InduwaraGayashan001/Misprinted-Label-Detection/README.md

# Misprinted Label Detection

This project aims to develop an automated system for detecting misprints on product packaging. By utilizing YOLOv8 for object detection and integrating with a PCB for automated responses, the system identifies and handles packaging errors efficiently.

## Features

- **Object Detection**: Leveraging YOLOv8 for accurate detection of misprints.
- **Automated Response**: Integration with a PCB to manage errors in real-time.
- **Efficiency**: Swift identification and correction of packaging issues.

## System Overview

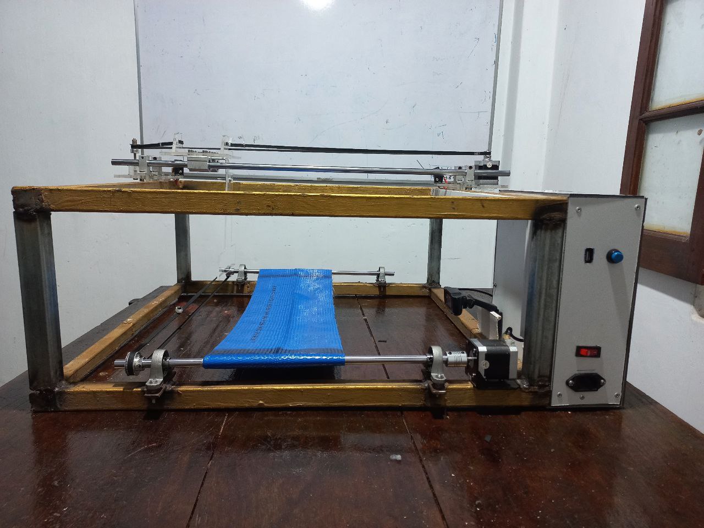
[picture p1: Detection_Results/system.jpg]
System Overview

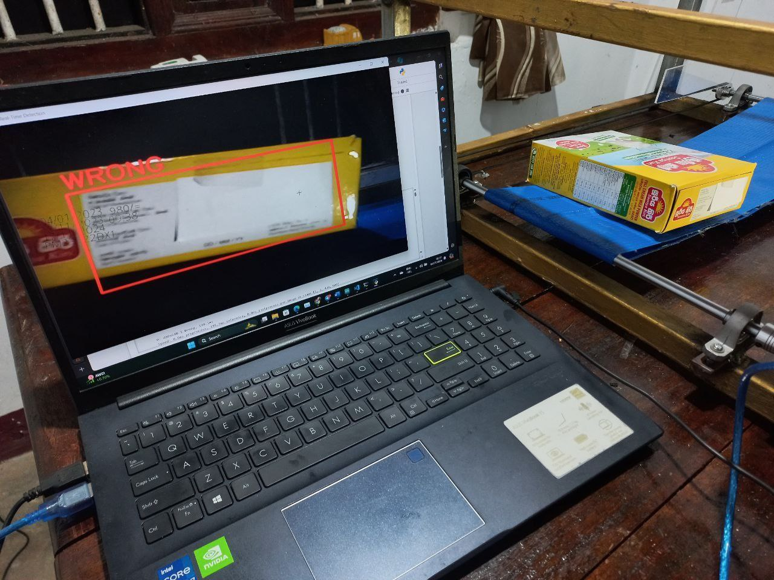
[picture p2: Detection_Results/detection.png]
