InduwaraGayashan001/Misprinted-Label-Detection/Codes/Data Augmentation/Initial data/IMG-20240511-WA0030.jpg

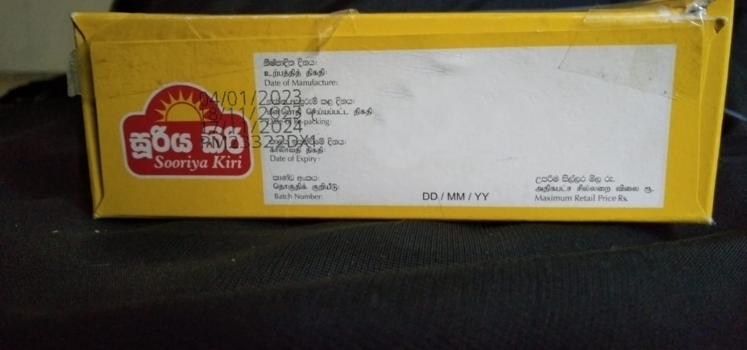
Codes/Data Augmentation/Initial data/IMG-20240511-WA0030.jpg
