InduwaraGayashan001/Misprinted-Label-Detection/Codes/Data Augmentation/Initial data/photo_2_2024-06-20_10-48-59.jpg

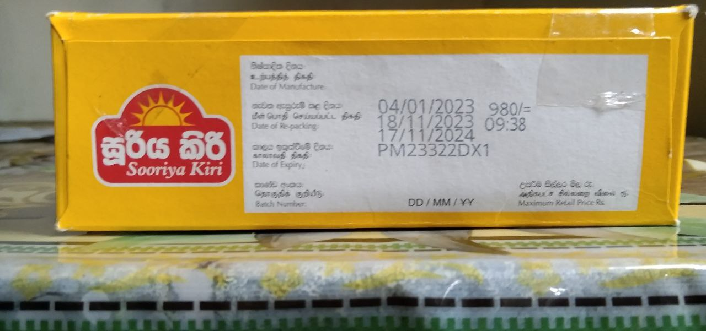
Codes/Data Augmentation/Initial data/photo_2_2024-06-20_10-48-59.jpg
