InduwaraGayashan001/Misprinted-Label-Detection/Solidworks/Mechanical design/Assembly.SLDASM

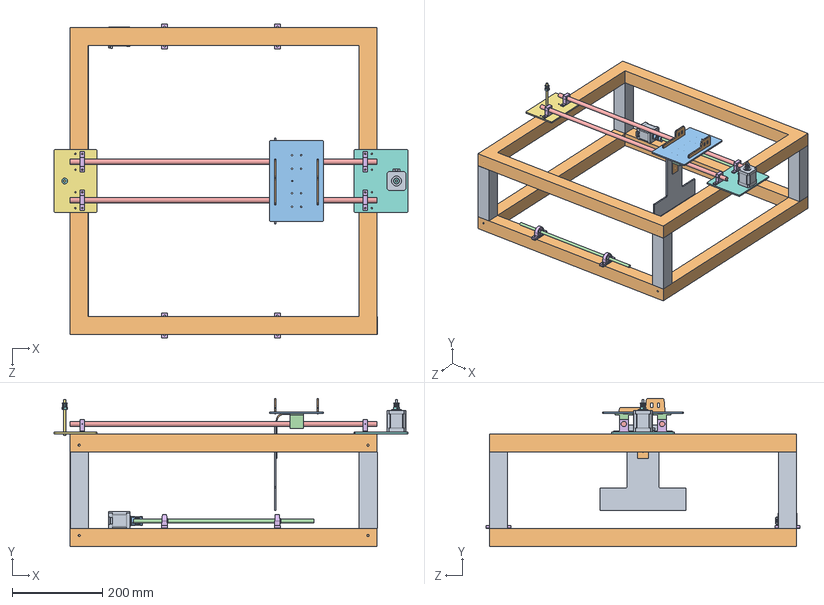
[picture p45: CAD file, 2024-07-12]
Solidworks/Mechanical design/Assembly.SLDASM
784.5 x 329.0 x 695.0 mm
base_frame x 2
vertical_bar x 4
fixed_plate_1
fixed_plate_2
horizontal_bar_holder(fixed) x 4
horizontal bar x 2
horizontal_bar_holder(moving) x 2
moving_plate
supporting_plate x 2
NEMA17 17HS8401 x 2
GT2_Pully_16T_6mm x 2
pulley_holder
pillow_bearing x 4
pillow_bearing_support x 4
conveyor_belt_bar x 2
flexible coupling v1
pushing_plate_holder
pshing_plate_1
