InduwaraGayashan001/Misprinted-Label-Detection/Solidworks/Enclosure design/S-120-12 PSU.SLDPRT

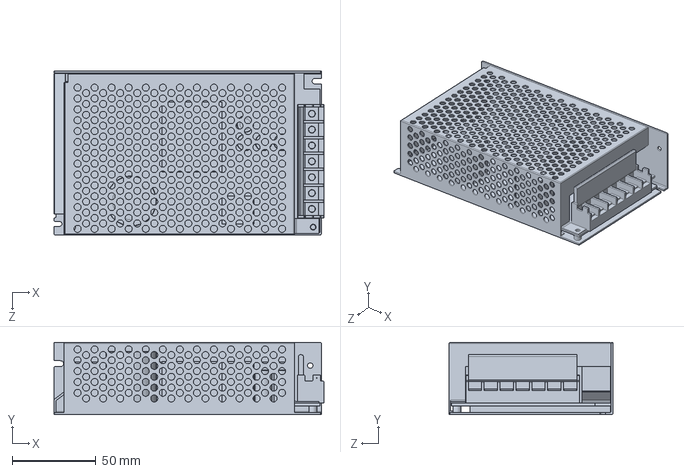
[picture p46: CAD file, 2024-07-12]
Solidworks/Enclosure design/S-120-12 PSU.SLDPRT
161.6 x 43.2 x 98.0 mm
