InduwaraGayashan001/Misprinted-Label-Detection/Solidworks/Mechanical design/NEMA17 17HS8401.SLDPRT

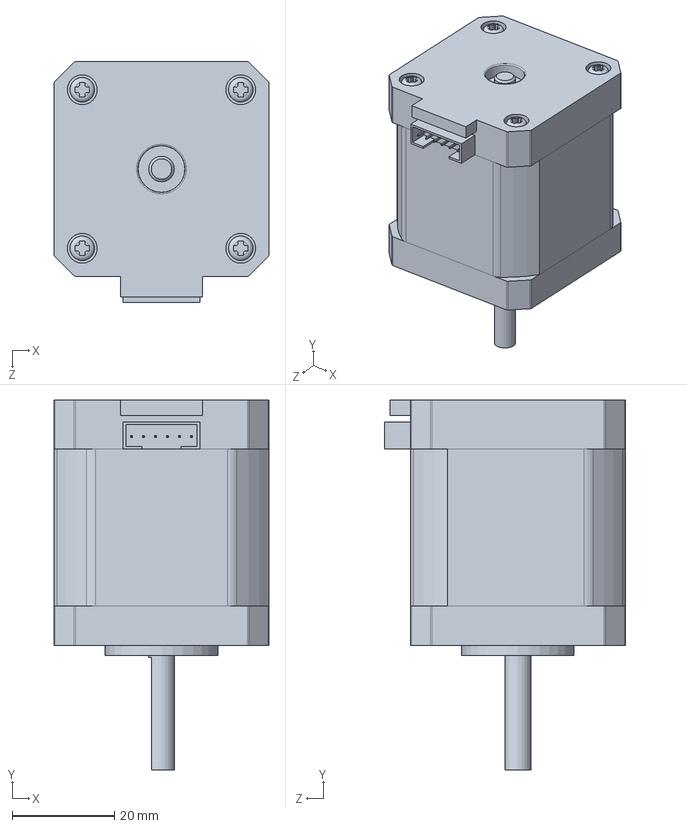
[picture p47: CAD file, 2024-07-12]
Solidworks/Mechanical design/NEMA17 17HS8401.SLDPRT
42.0 x 72.4 x 47.1 mm
