InduwaraGayashan001/Misprinted-Label-Detection/Solidworks/Enclosure design/SMAKN TB6600 Stepper Motor Driver.SLDPRT

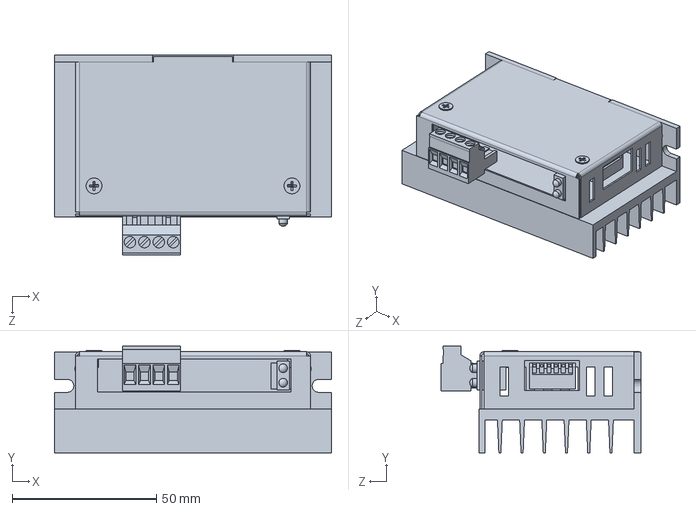
[picture p48: CAD file, 2024-07-12]
Solidworks/Enclosure design/SMAKN TB6600 Stepper Motor Driver.SLDPRT
96.0 x 37.0 x 69.2 mm
