InduwaraGayashan001/Misprinted-Label-Detection/Solidworks/Mechanical design/fixed_plate_1.SLDPRT

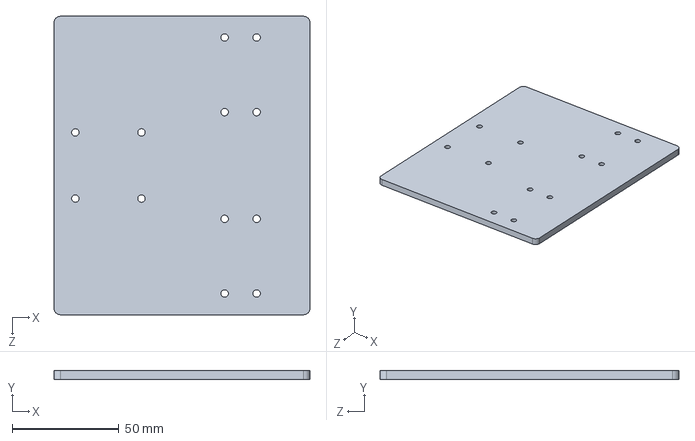
[picture p49: CAD file, 2024-07-12]
Solidworks/Mechanical design/fixed_plate_1.SLDPRT
120.0 x 4.00 x 140.0 mm
