InduwaraGayashan001/Misprinted-Label-Detection/Solidworks/Enclosure design/KCD1-B2-2P-Off.SLDPRT

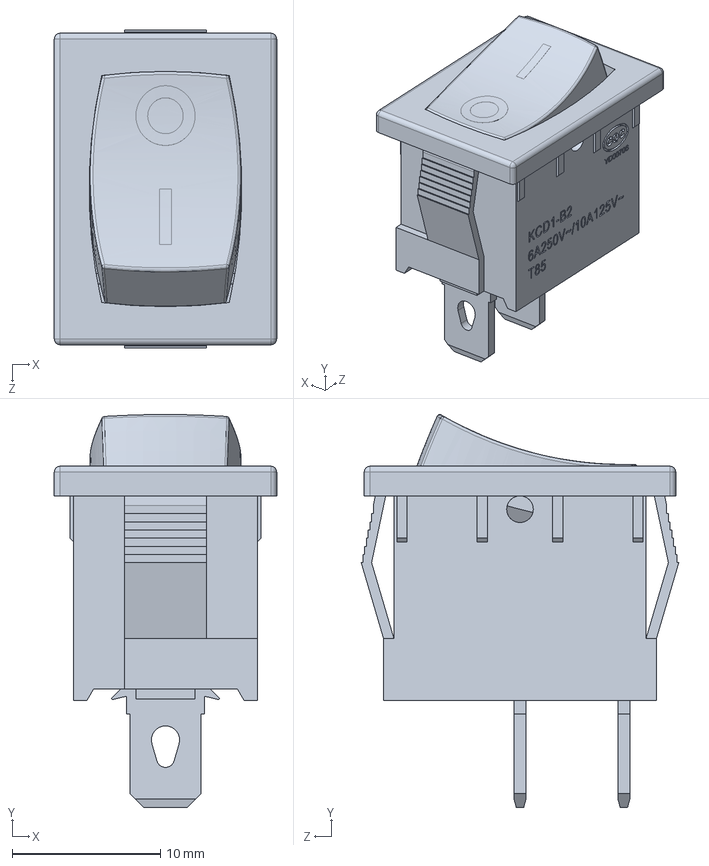
[picture p50: CAD file, 2024-07-12]
Solidworks/Enclosure design/KCD1-B2-2P-Off.SLDPRT
15.0 x 26.5 x 21.4 mm
