InduwaraGayashan001/Misprinted-Label-Detection/Solidworks/Enclosure design/Part2.SLDPRT

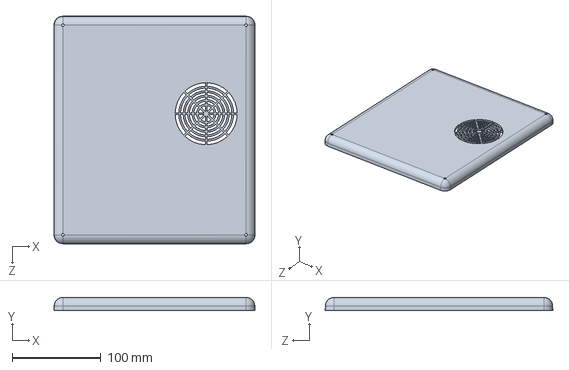
[picture p51: CAD file, 2024-07-12]
Solidworks/Enclosure design/Part2.SLDPRT
226.9 x 15.0 x 256.9 mm
