InduwaraGayashan001/Misprinted-Label-Detection/Solidworks/Mechanical design/pillow_bearing_support.SLDPRT

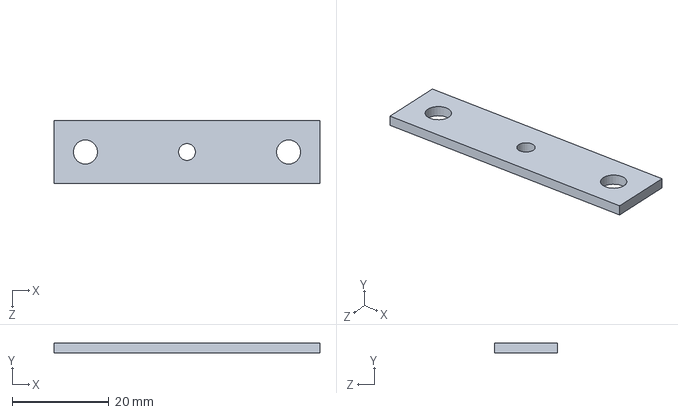
[picture p52: CAD file, 2024-07-12]
Solidworks/Mechanical design/pillow_bearing_support.SLDPRT
55.0 x 2.00 x 13.0 mm
