InduwaraGayashan001/Misprinted-Label-Detection/Solidworks/Enclosure design/Part1.SLDPRT

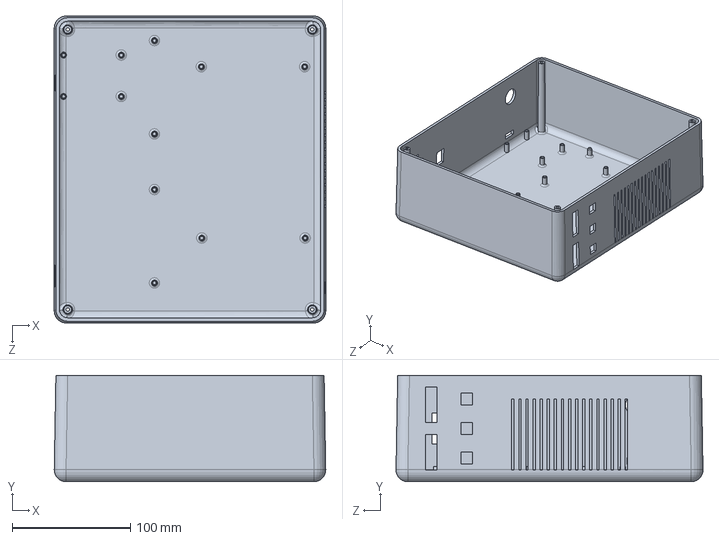
[picture p53: CAD file, 2024-07-12]
Solidworks/Enclosure design/Part1.SLDPRT
229.6 x 90.0 x 259.6 mm
