InduwaraGayashan001/Misprinted-Label-Detection/Solidworks/Mechanical design/horizontal bar.SLDPRT

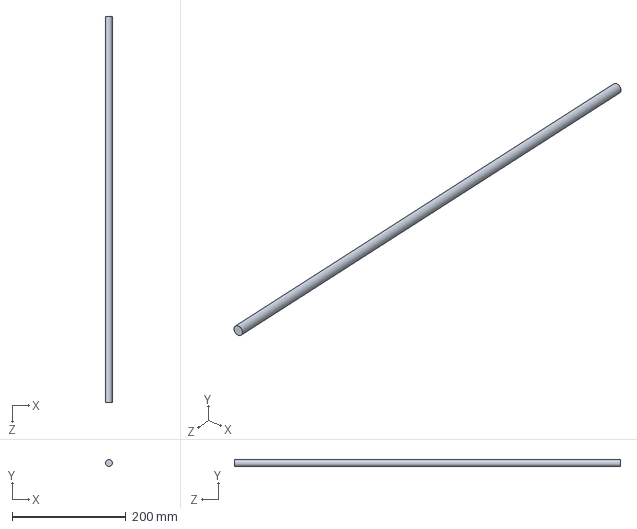
[picture p54: CAD file, 2024-07-12]
Solidworks/Mechanical design/horizontal bar.SLDPRT
12.0 x 12.0 x 680.0 mm
