InduwaraGayashan001/Misprinted-Label-Detection/Solidworks/Enclosure design/16mmPushButton.SLDPRT

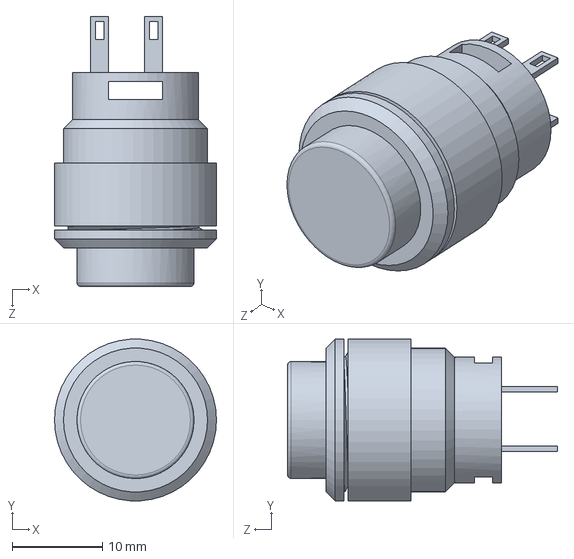
[picture p55: CAD file, 2024-07-12]
Solidworks/Enclosure design/16mmPushButton.SLDPRT
18.0 x 18.0 x 30.0 mm
