InduwaraGayashan001/Misprinted-Label-Detection/Solidworks/Mechanical design/vertical_bar.SLDPRT

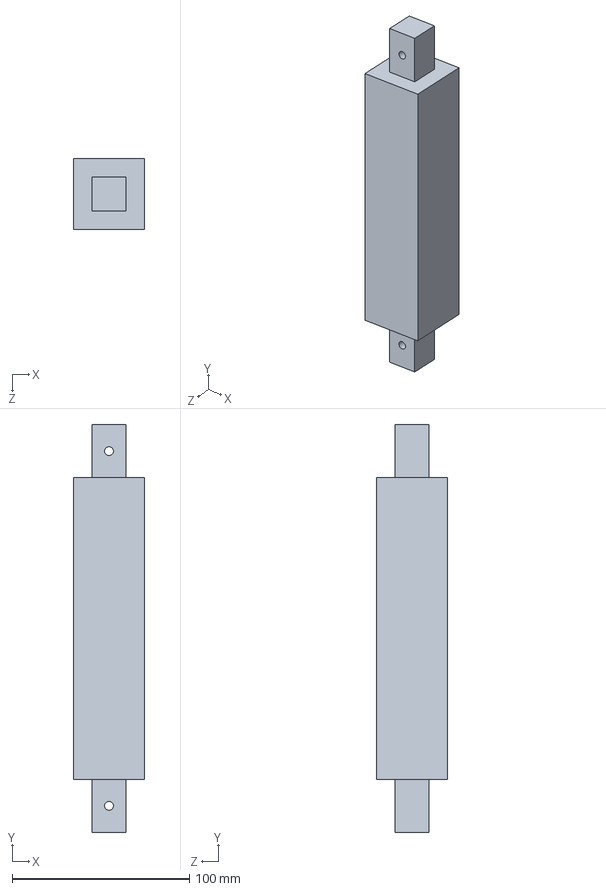
[picture p56: CAD file, 2024-07-12]
Solidworks/Mechanical design/vertical_bar.SLDPRT
40.0 x 230.0 x 40.0 mm
