InduwaraGayashan001/Misprinted-Label-Detection/Solidworks/Enclosure design/HB5_.SLDPRT

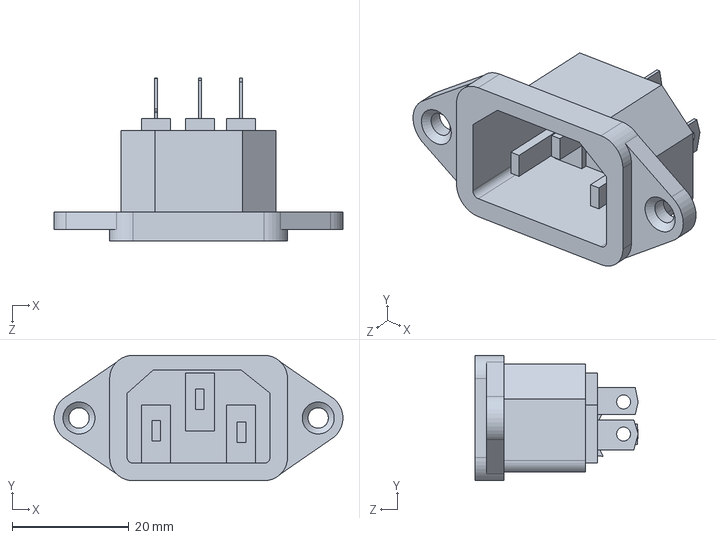
[picture p57: CAD file, 2024-07-12]
Solidworks/Enclosure design/HB5_.SLDPRT
49.5 x 21.5 x 28.0 mm
