InduwaraGayashan001/Misprinted-Label-Detection/Solidworks/Mechanical design/pushing_plate_holder.SLDPRT

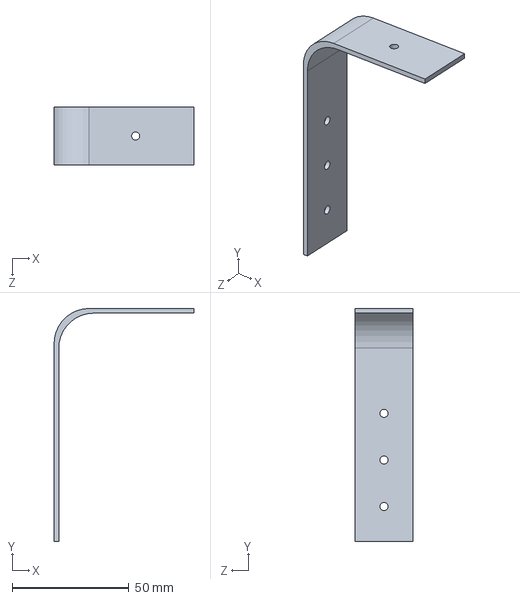
[picture p58: CAD file, 2024-07-12]
Solidworks/Mechanical design/pushing_plate_holder.SLDPRT
60.0 x 100.0 x 25.0 mm
