InduwaraGayashan001/Misprinted-Label-Detection/Solidworks/Mechanical design/horizontal_bar_holder(fixed).SLDPRT

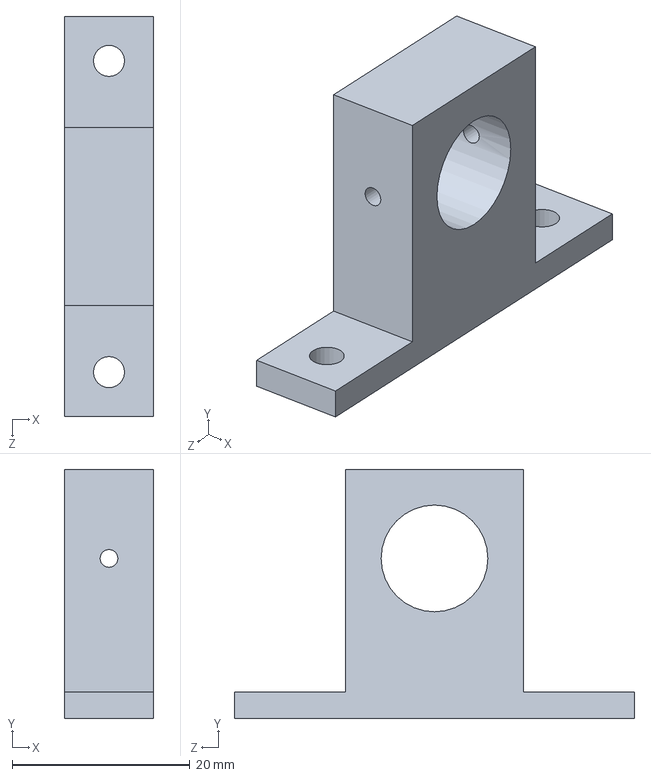
[picture p59: CAD file, 2024-07-12]
Solidworks/Mechanical design/horizontal_bar_holder(fixed).SLDPRT
10.0 x 28.0 x 45.0 mm
