InduwaraGayashan001/Misprinted-Label-Detection/Solidworks/Mechanical design/pulley_holder.SLDPRT

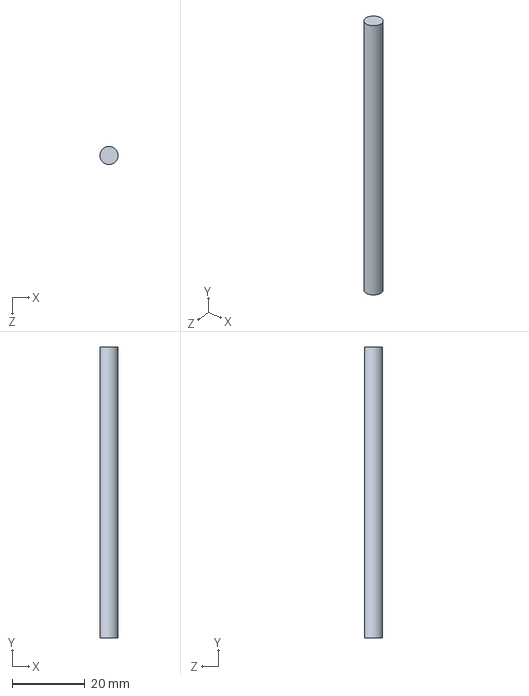
[picture p60: CAD file, 2024-07-12]
Solidworks/Mechanical design/pulley_holder.SLDPRT
4.99 x 80.0 x 5.00 mm
