InduwaraGayashan001/Misprinted-Label-Detection/Solidworks/Mechanical design/base_frame.SLDPRT

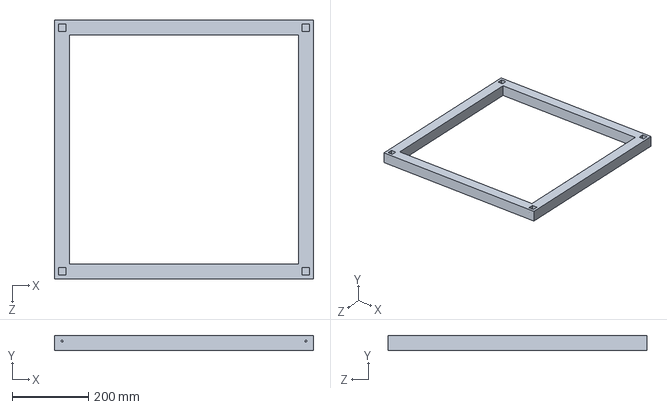
[picture p61: CAD file, 2024-07-12]
Solidworks/Mechanical design/base_frame.SLDPRT
680.0 x 40.0 x 680.0 mm
