InduwaraGayashan001/Misprinted-Label-Detection/Solidworks/Mechanical design/moving_plate.SLDPRT

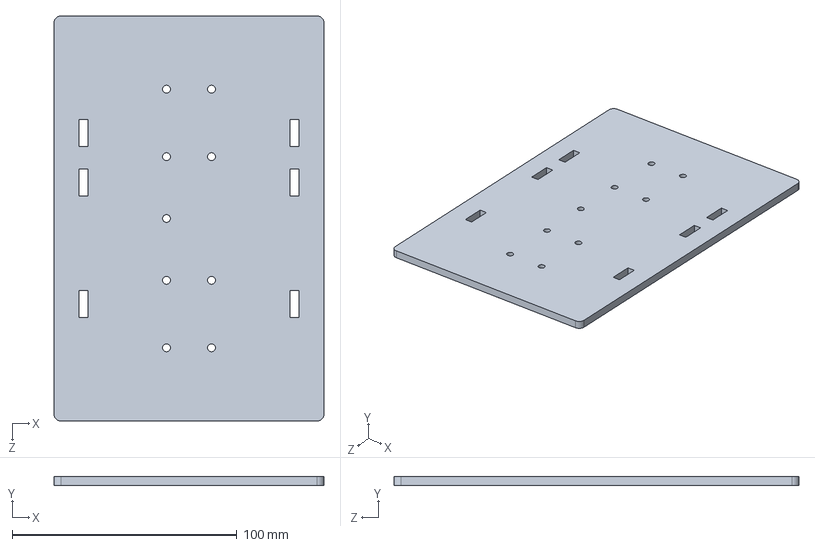
[picture p62: CAD file, 2024-07-12]
Solidworks/Mechanical design/moving_plate.SLDPRT
120.0 x 4.00 x 180.0 mm
