InduwaraGayashan001/Misprinted-Label-Detection/Solidworks/Mechanical design/GT2_Pully_16T_6mm.SLDPRT

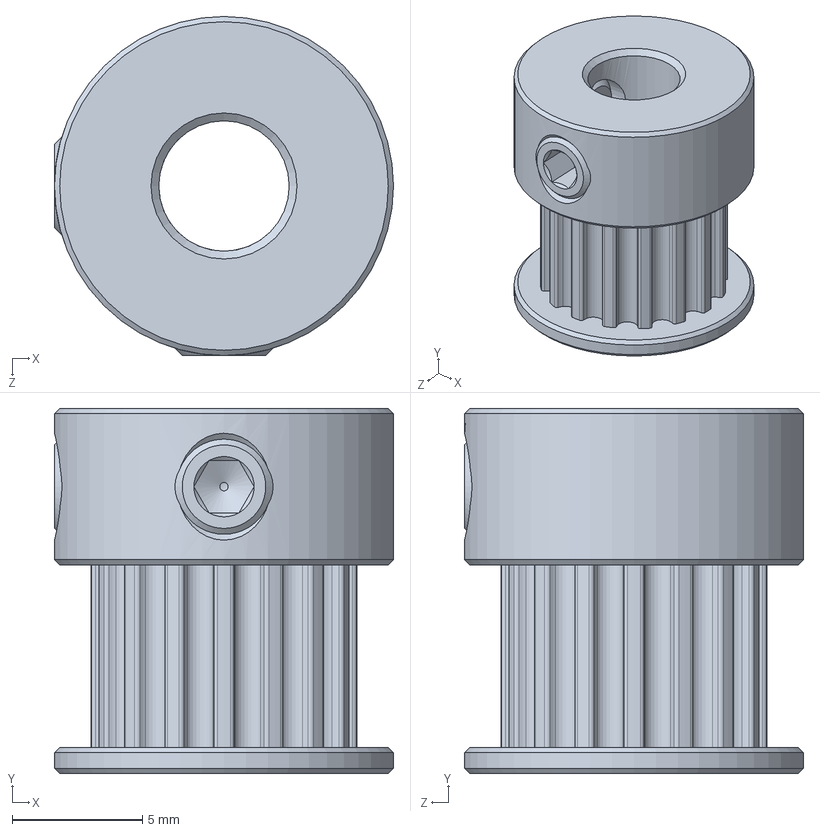
[picture p63: CAD file, 2024-07-12]
Solidworks/Mechanical design/GT2_Pully_16T_6mm.SLDPRT
13.0 x 14.0 x 13.0 mm
