InduwaraGayashan001/Misprinted-Label-Detection/Solidworks/Mechanical design/flexible coupling v1.SLDPRT

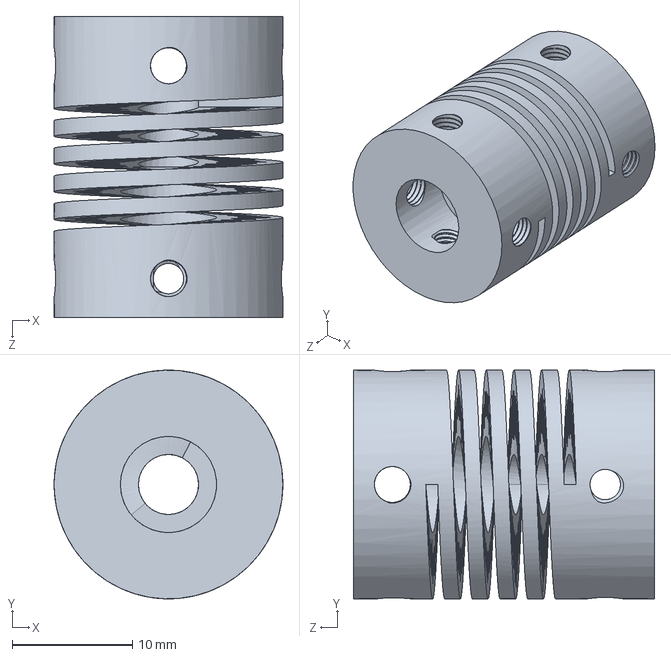
[picture p64: CAD file, 2024-07-12]
Solidworks/Mechanical design/flexible coupling v1.SLDPRT
19.0 x 19.0 x 25.0 mm
