InduwaraGayashan001/Misprinted-Label-Detection/Solidworks/Mechanical design/pillow_bearing.SLDPRT

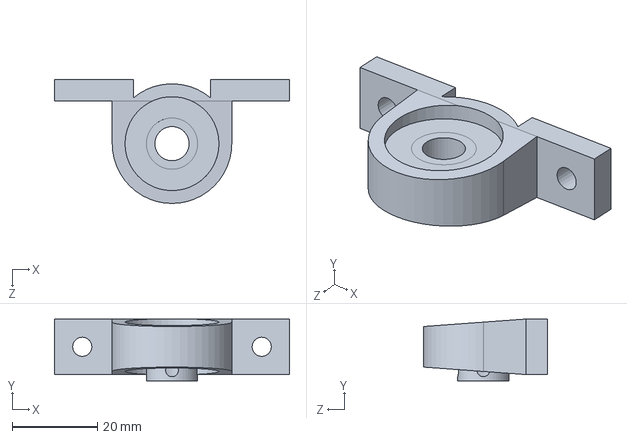
[picture p65: CAD file, 2024-07-12]
Solidworks/Mechanical design/pillow_bearing.SLDPRT
55.0 x 14.5 x 29.0 mm
