InduwaraGayashan001/Misprinted-Label-Detection/Solidworks/Mechanical design/conveyor_belt_bar.SLDPRT

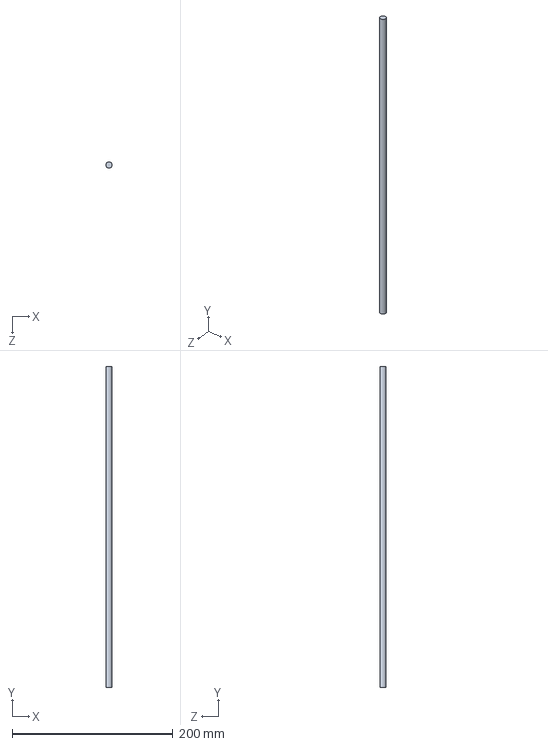
[picture p66: CAD file, 2024-07-12]
Solidworks/Mechanical design/conveyor_belt_bar.SLDPRT
8.00 x 400.0 x 8.00 mm
