InduwaraGayashan001/Misprinted-Label-Detection/Solidworks/Mechanical design/pshing_plate_1.SLDPRT

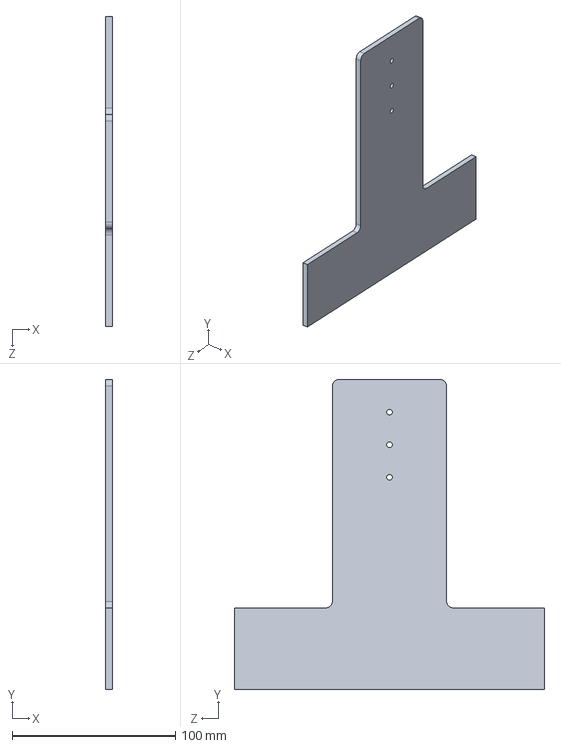
[picture p67: CAD file, 2024-07-12]
Solidworks/Mechanical design/pshing_plate_1.SLDPRT
4.00 x 190.0 x 190.0 mm
