InduwaraGayashan001/Misprinted-Label-Detection/Solidworks/Mechanical design/supporting_plate.SLDPRT

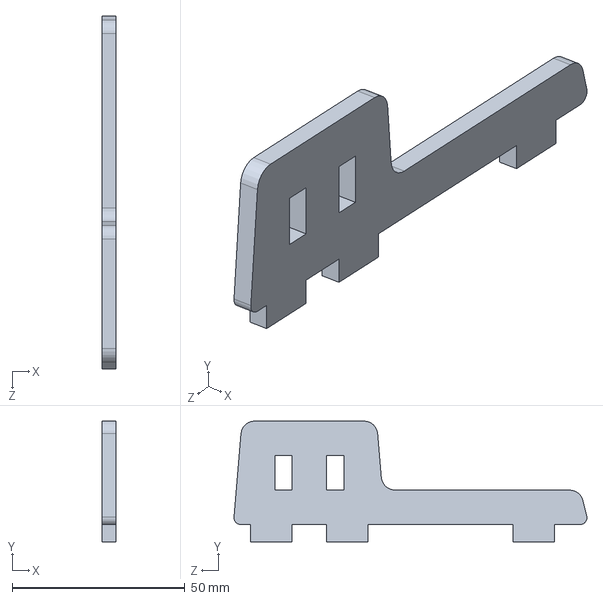
[picture p68: CAD file, 2024-07-12]
Solidworks/Mechanical design/supporting_plate.SLDPRT
4.00 x 35.0 x 102.3 mm
