InduwaraGayashan001/Misprinted-Label-Detection/Solidworks/Mechanical design/fixed_plate_2.SLDPRT

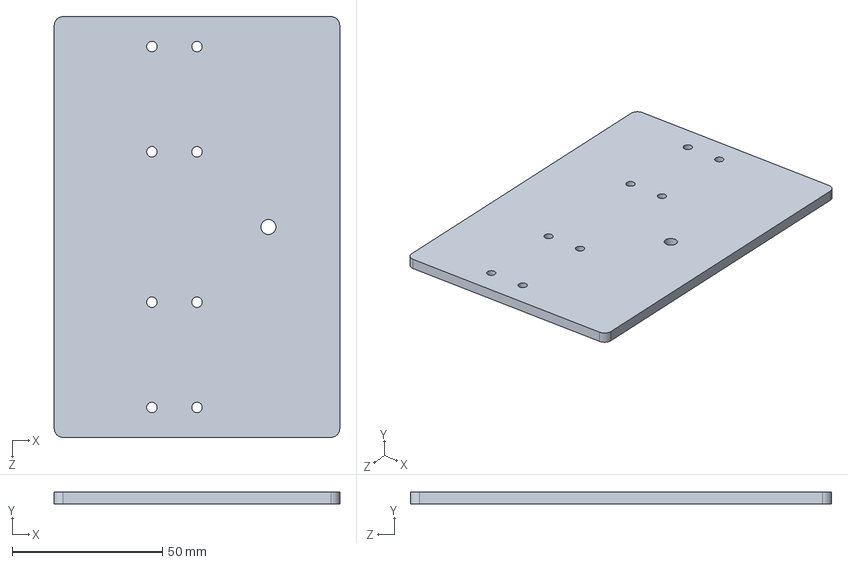
[picture p69: CAD file, 2024-07-12]
Solidworks/Mechanical design/fixed_plate_2.SLDPRT
95.0 x 4.00 x 140.0 mm
