InduwaraGayashan001/Misprinted-Label-Detection/Solidworks/Mechanical design/horizontal_bar_holder(moving).SLDPRT

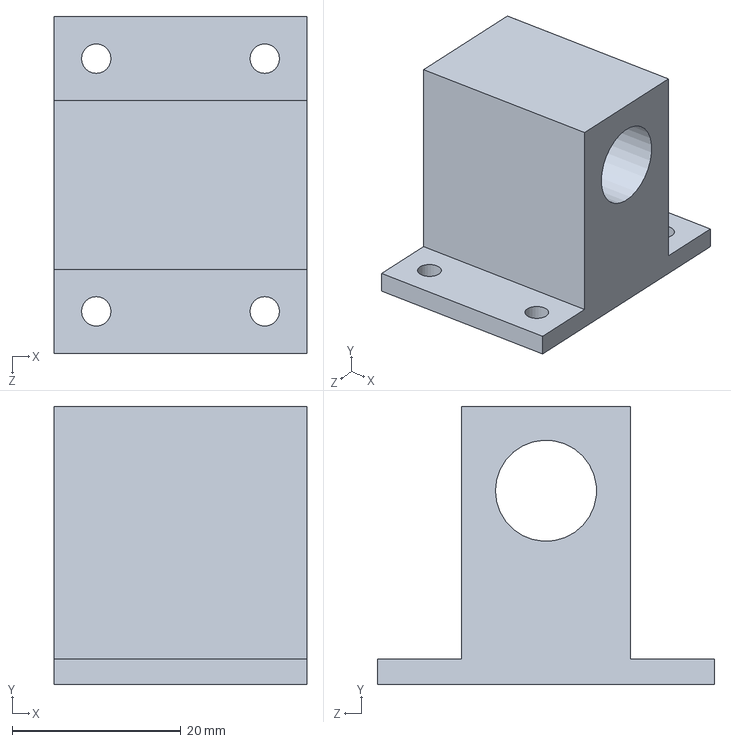
[picture p70: CAD file, 2024-07-12]
Solidworks/Mechanical design/horizontal_bar_holder(moving).SLDPRT
30.0 x 33.0 x 40.0 mm
