InduwaraGayashan001/Misprinted-Label-Detection/(list of files, cad)

Other CAD files:
Solidworks/Enclosure design/Drawings.SLDDRW
