InduwaraGayashan001/Misprinted-Label-Detection/Detection_Results/Correct Label .png

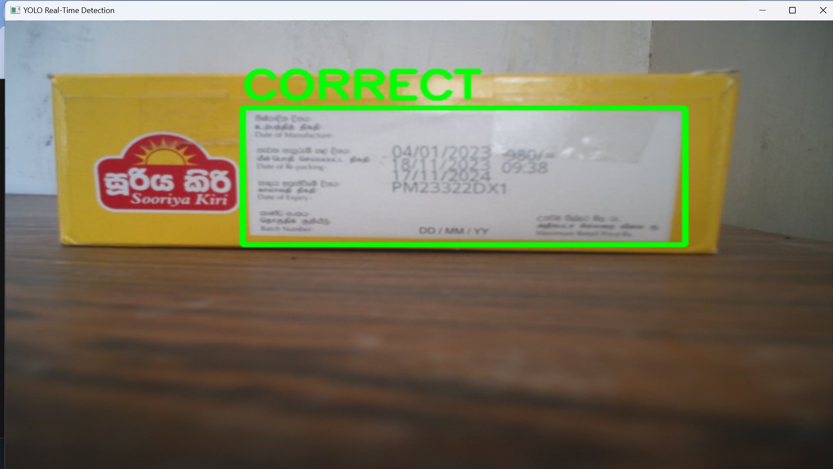
Detection_Results/Correct Label .png
