InduwaraGayashan001/Misprinted-Label-Detection/Detection_Results/Wrong Label.png

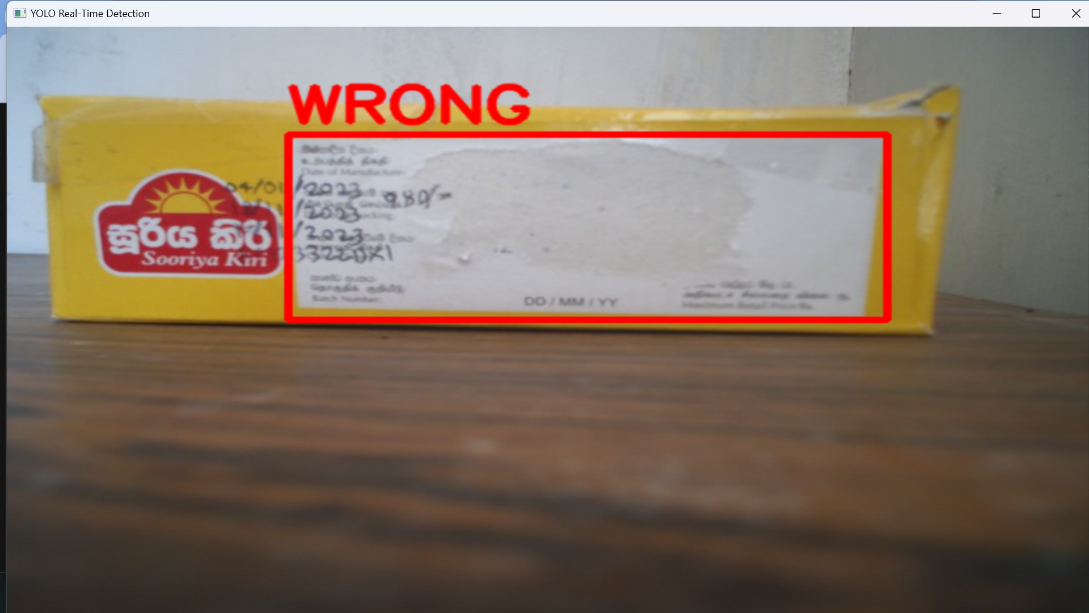
Detection_Results/Wrong Label.png
