InduwaraGayashan001/Misprinted-Label-Detection/PCB/Schematics.pdf

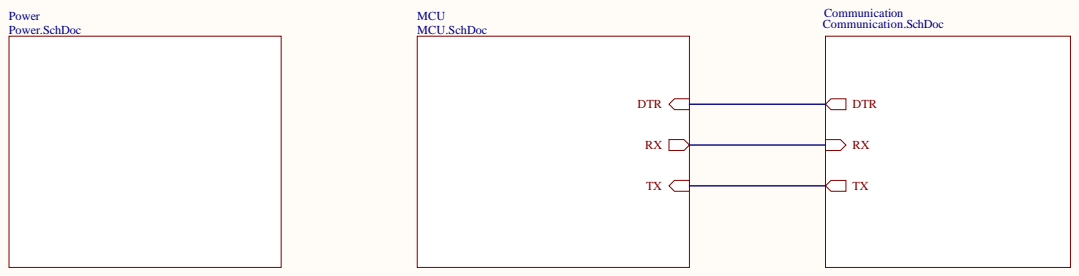
[picture p73: page 1]
Title; Size; Number; Revision; Date:; Sheet of; File:; C:\Users\..\Main.SchDoc; Drawn By:; Power Power.SchDoc; DTR; MCU MCU.SchDoc; Block Diagram; Group No 41

Communication Communication.SchDoc

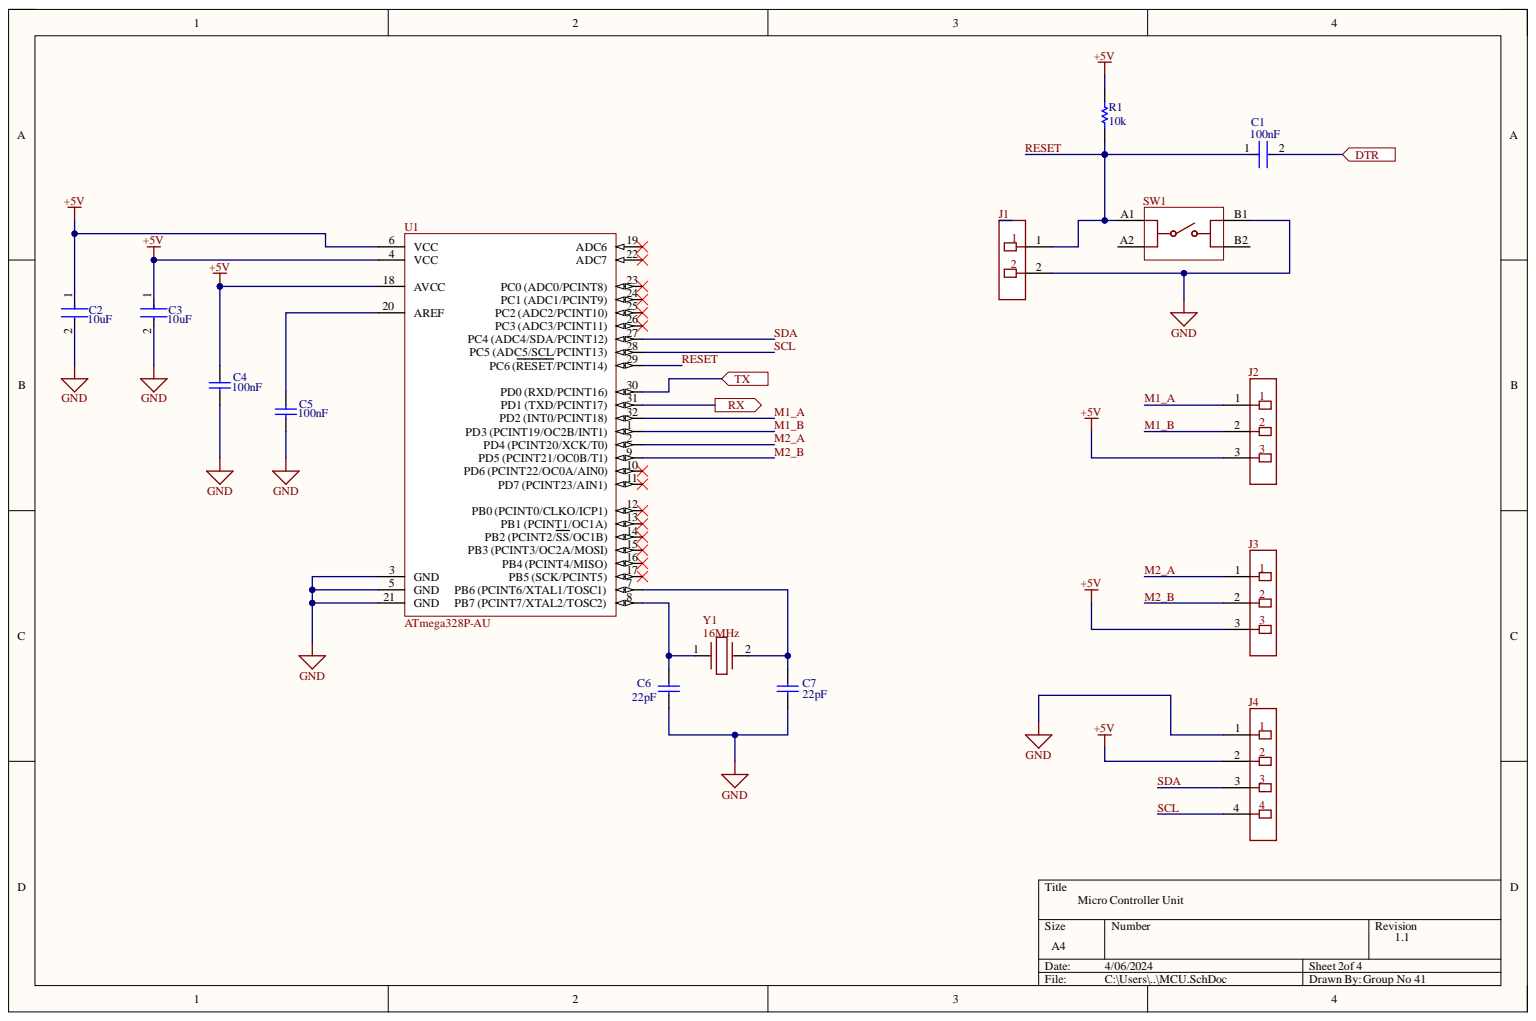
[picture p74: page 2]

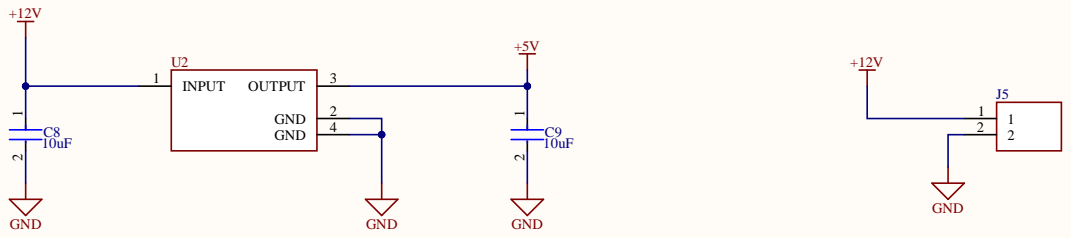
[picture p75: page 3]
Size; umb; Rev; wer.Sch; INPU; wer In; 4Gro

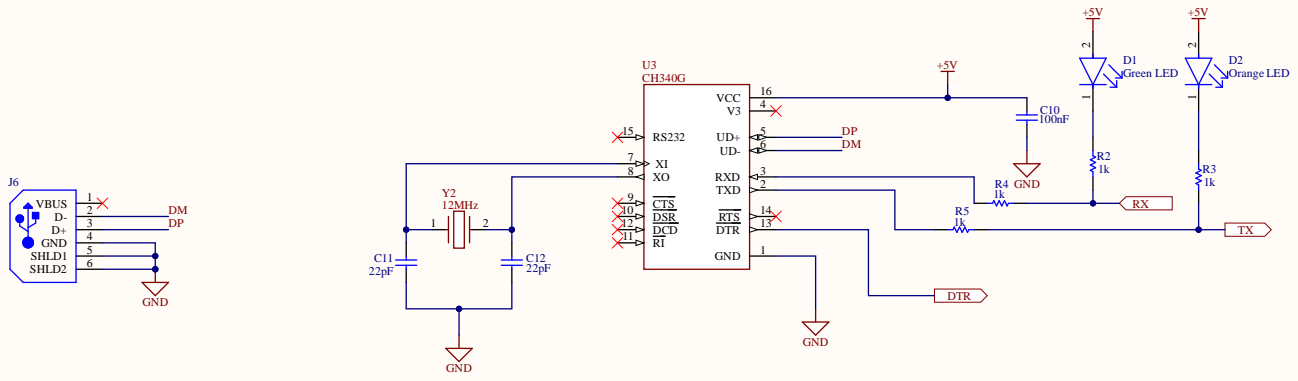
[picture p76: page 4]
Size; umb; Rev; \..\Commu; icat; Oran; VBU; DSR; VCC; USB; 4Gro; Green L
