InduwaraGayashan001/Misprinted-Label-Detection/Solidworks/Enclosure design/Drawings.pdf

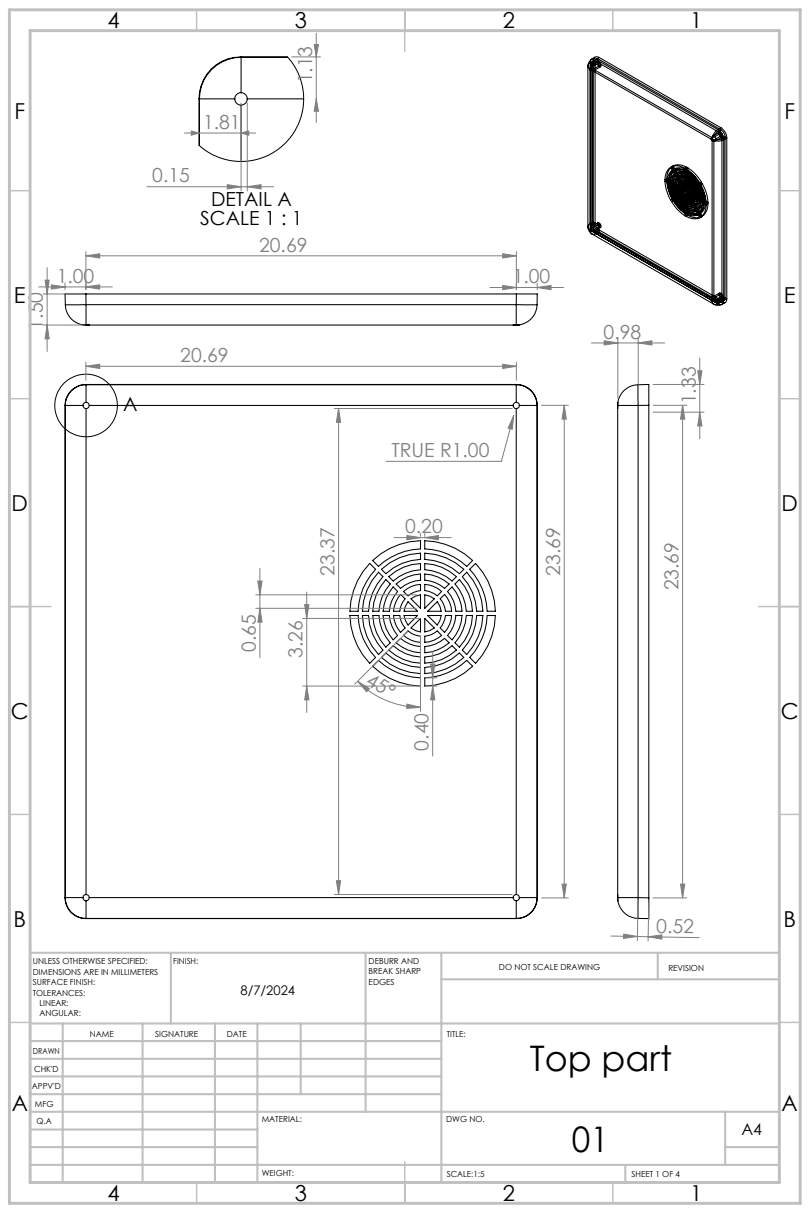
[picture p77: page 1]
TRUE R1.00 0.40; DETAIL A SCALE 1 : 1; FINISH:; DEBURR AND; BREAK SHARP; DO NOT SCALE DRAWING; REVISION; SCALE:1:5; SHEET 1 OF 4

UNLESS OTHERWISE SPECIFIED:
DIMENSIONS ARE IN MILLIMETERS
SURFACE FINISH:
TOLERANCES:
LINEAR:
ANGULAR:

NAME | SIGNATURE | DATE | | | | TITLE: Top part

DRAWN
CHK'D
APPV'D
MFG
Q.A | | | | MATERIAL: | DWG NO. | A4

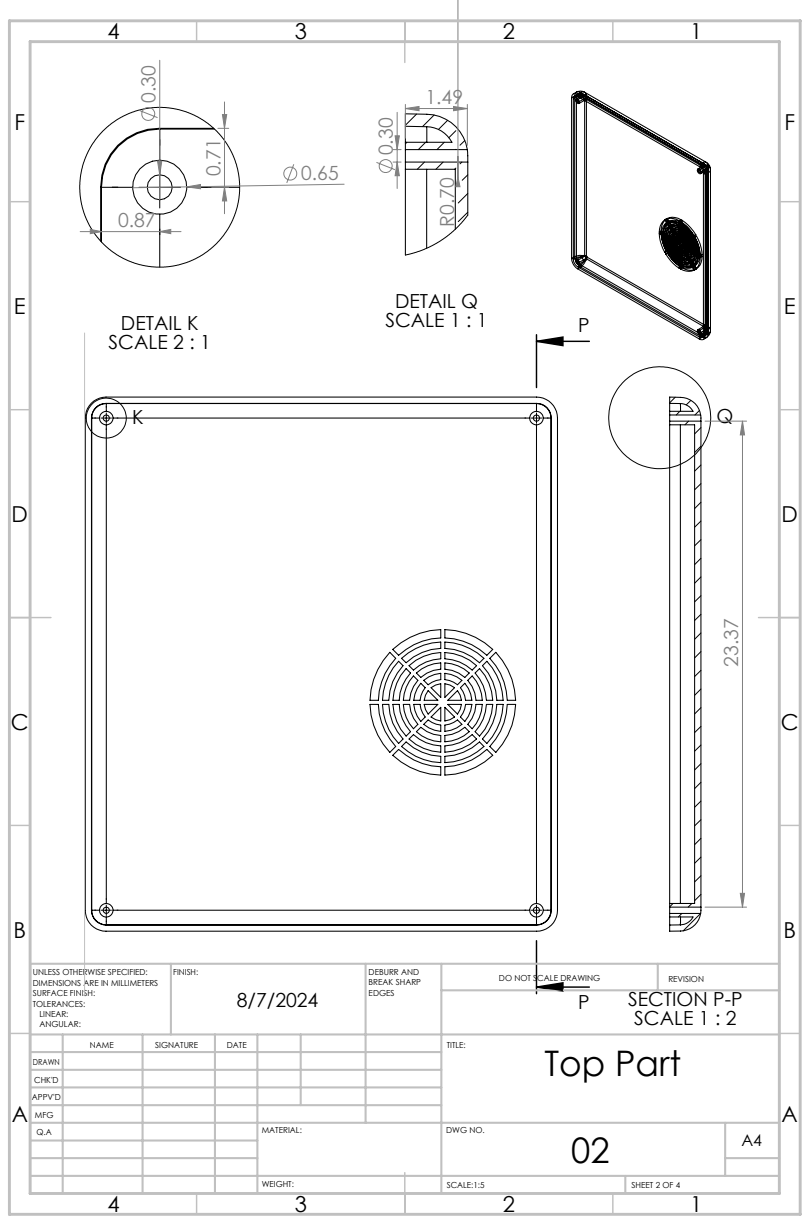
[picture p78: page 2]
DETAIL K SCALE 2 : 1; SECTION P-P SCALE 1 : 2; DETAIL Q SCALE 1 : 1; FINISH:; DEBURR AND; BREAK SHARP; DO NOT SCALE DRAWING; REVISION

UNLESS OTHERWISE SPECIFIED:
DIMENSIONS ARE IN MILLIMETERS
SURFACE FINISH:
TOLERANCES:
LINEAR:
ANGULAR:

NAME | SIGNATURE | DATE | TITLE: Top Part

DRAWN
CHK'D
APPV'D
MFG

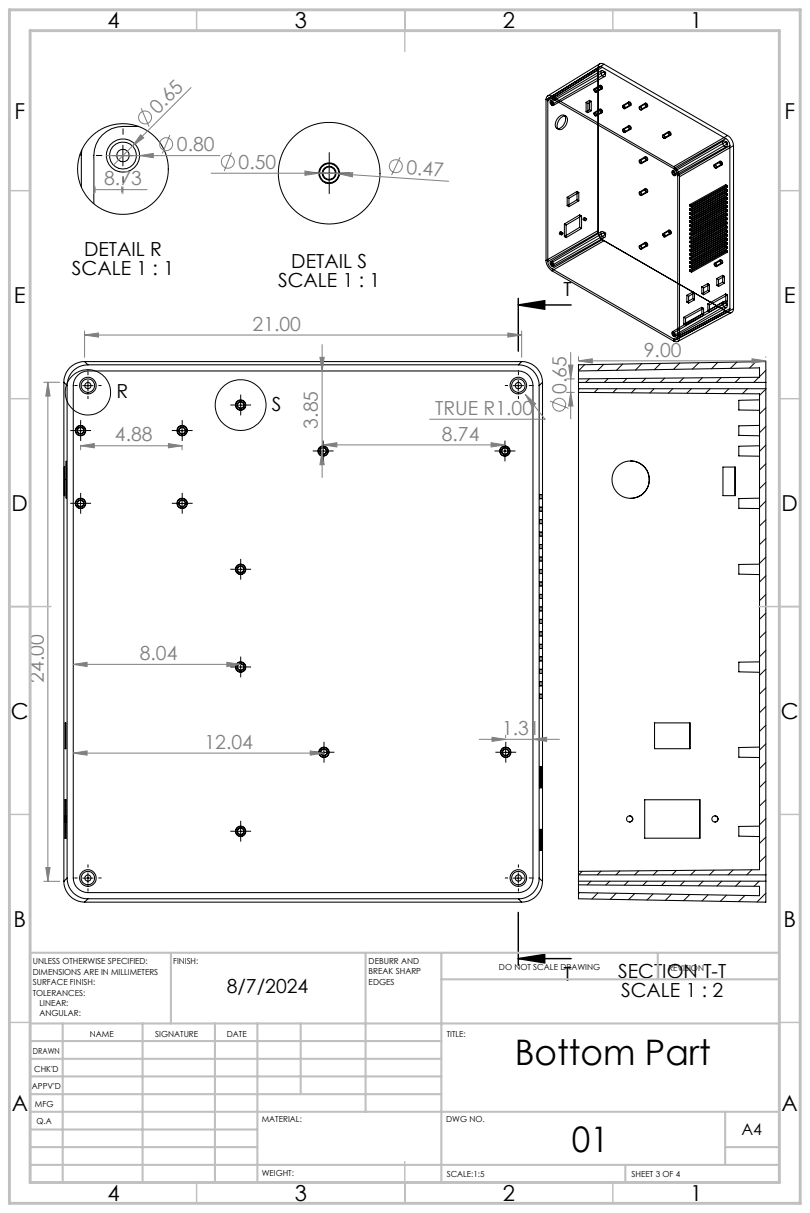
[picture p79: page 3]
TRUE R1.00; DETAIL R SCALE 1 : 1; DETAIL S SCALE 1 : 1; SECTION T-T SCALE 1 : 2; FINISH:; DEBURR AND; BREAK SHARP; DO NOT SCALE DRAWING; REVISION

UNLESS OTHERWISE SPECIFIED:
DIMENSIONS ARE IN MILLIMETERS
SURFACE FINISH:
TOLERANCES:
LINEAR:
ANGULAR:

NAME | SIGNATURE | DATE | TITLE: Bottom Part

DRAWN
CHK'D
APPV'D
MFG

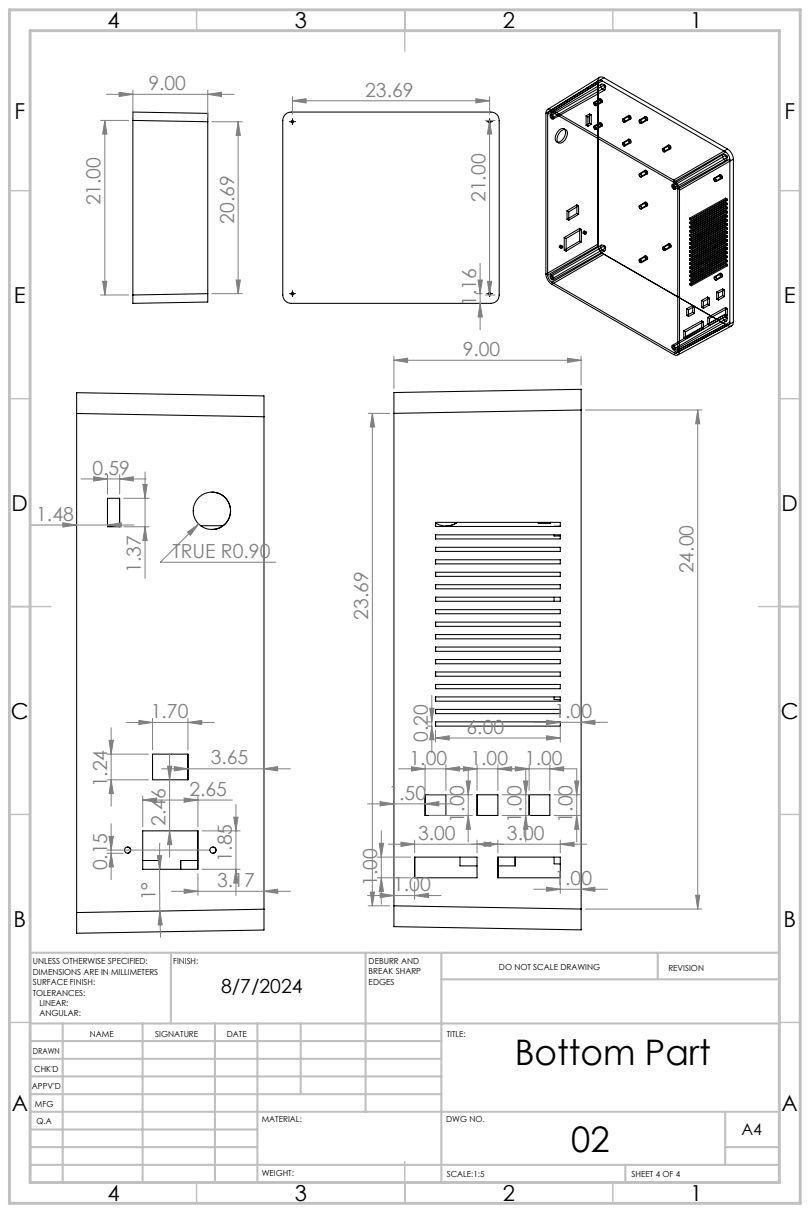
[picture p80: page 4]
TRUE R0.90; FINISH:; DEBURR AND; BREAK SHARP; DO NOT SCALE DRAWING; REVISION

UNLESS OTHERWISE SPECIFIED:
DIMENSIONS ARE IN MILLIMETERS
SURFACE FINISH:
TOLERANCES:
LINEAR:
ANGULAR:

NAME | SIGNATURE | DATE | TITLE: Bottom Part

DRAWN
CHK'D
APPV'D
MFG
