InduwaraGayashan001/Misprinted-Label-Detection/(commit log)

2024-06-23 Add files via upload
    Uploaded the hardware design files and design documents
    [Part1.SLDPRT, Part2.SLDPRT]
2024-07-12 Updated the documents and prediction source code files
    [Part1.SLDPRT, Part2.SLDPRT]
2024-07-12 Updated the Solidworks design files
    [16mmPushButton.SLDPRT, Assembly.SLDASM, Drawings.SLDDRW, GT2_Pully_16T_6mm.SLDPRT, HB5_.SLDPRT, KCD1-B2-2P-Off.SLDPRT, NEMA17 17HS8401.SLDPRT, Part1.SLDPRT]
